jazzrobot/gshp-ebus/tools/README.md

# Tools

Helper scripts and utilities for maintaining the repository and processing captures live here.

See [scripts/README.md](scripts/README.md) for current scripts.
