jazzrobot/gshp-ebus/docs/decisions/README.md

# Architecture Decision Records

This directory records the decisions that shape the project in non-obvious ways.

Use an ADR when a choice changes safety, architecture, or future flexibility.

Current records:

- [0001-passive-read-only-mvp.md](0001-passive-read-only-mvp.md) - keep the MVP passive, isolated, and non-transmitting
