jazzrobot/gshp-ebus/home-assistant/entities/README.md

# Entities

This directory will hold the final list of Home Assistant entities once Phase 2 starts.

Likely early entities:

- target flow temperature
- actual flow temperature
- return temperature
- brine in temperature
- brine out temperature
- compressor state
