jazzrobot/gshp-ebus/tools/scripts/README.md

# Scripts

Current scripts:

- [generate-repo-structure.sh](generate-repo-structure.sh) - refresh `docs/repo-structure.md`
