jazzrobot/gshp-ebus/docs/repo-structure.md

# Repository Structure

This file is generated by `tools/scripts/generate-repo-structure.sh`.
Do not edit by hand.

```
.
├── docs
│   ├── architecture
│   │   ├── mvp-plan.md
│   │   └── overview.md
│   ├── debugging
│   │   └── common-failures.md
│   ├── decisions
│   │   ├── 0001-passive-read-only-mvp.md
│   │   └── README.md
│   ├── setup
│   │   └── live-ebus-install-checklist.md
│   ├── README.md
│   └── repo-structure.md
├── firmware
│   ├── esp32-s3-poe
│   │   ├── current
│   │   │   └── README.md
│   │   ├── dev
│   │   │   └── README.md
│   │   ├── README.md
│   │   └── VERSION_NOTES.md
│   └── README.md
├── hardware
│   ├── mechanical
│   │   └── README.md
│   ├── proto-v1
│   │   ├── README.md
│   │   ├── bom.csv
│   │   ├── build-notes.md
│   │   └── front-end.md
│   ├── proto-v2
│   │   ├── kicad
│   │   │   ├── README.md
│   │   │   ├── capture-notes.md
│   │   │   ├── ebus-rx-only.kicad_pro
│   │   │   └── ebus-rx-only.kicad_sch
│   │   ├── README.md
│   │   ├── bom.csv
│   │   ├── front-end.md
│   │   └── pcb-layout-notes.md
│   ├── proto-v3
│   │   └── README.md
│   └── README.md
├── home-assistant
│   ├── entities
│   │   └── README.md
│   ├── packages
│   │   └── README.md
│   └── README.md
├── logs
│   ├── bench-tests
│   │   └── README.md
│   ├── bus-captures
│   │   └── README.md
│   └── README.md
├── tools
│   ├── scripts
│   │   ├── README.md
│   │   └── generate-repo-structure.sh
│   └── README.md
├── CONVENTIONS.md
├── GETTING_STARTED.md
└── README.md

24 directories, 40 files
```
