jazzrobot/gshp-ebus/logs/bench-tests/README.md

# Bench Tests

Use this directory for bench validation notes before anything is attached to the live system.

Useful contents:

- interface validation notes
- firmware bring-up observations
- known-good and known-bad test conditions
