jazzrobot/gshp-ebus/logs/bus-captures/2026-03-23-tado-system-tests-2-time-anchors.csv

start_us | end_us | reason | wall_clock | weekday_bus | frame
169975763704 | 169975827550 | sync_boundary | 2026-03-23 22:05:12 | 1 | AA 10 FE B5 16 08 00 12 05 22 23 03 01 26 E2
170035751529 | 170035815335 | sync_boundary | 2026-03-23 22:06:12 | 1 | AA 10 FE B5 16 08 00 12 06 22 23 03 01 26 56
170095730204 | 170095793943 | sync_boundary | 2026-03-23 22:07:12 | 1 | AA 10 FE B5 16 08 00 12 07 22 23 03 01 26 B3
170155794118 | 170155857922 | sync_boundary | 2026-03-23 22:08:12 | 1 | AA 10 FE B5 16 08 00 12 08 22 23 03 01 26 7A
170215789040 | 170215852798 | sync_boundary | 2026-03-23 22:09:12 | 1 | AA 10 FE B5 16 08 00 12 09 22 23 03 01 26 9F
170276236131 | 170276300025 | sync_boundary | 2026-03-23 22:10:12 | 1 | AA 10 FE B5 16 08 00 12 10 22 23 03 01 26 80
170335741320 | 170335804975 | sync_boundary | 2026-03-23 22:11:12 | 1 | AA 10 FE B5 16 08 00 12 11 22 23 03 01 26 65
170395761729 | 170395825534 | sync_boundary | 2026-03-23 22:12:12 | 1 | AA 10 FE B5 16 08 00 12 12 22 23 03 01 26 D1
170455744669 | 170455808336 | sync_boundary | 2026-03-23 22:13:12 | 1 | AA 10 FE B5 16 08 00 12 13 22 23 03 01 26 34
170515695110 | 170515758581 | sync_boundary | 2026-03-23 22:14:12 | 1 | AA 10 FE B5 16 08 00 12 14 22 23 03 01 26 22
170578764178 | 170578827839 | sync_boundary | 2026-03-23 22:15:12 | 1 | AA 10 FE B5 16 08 00 12 15 22 23 03 01 26 C7
170635682116 | 170635745910 | sync_boundary | 2026-03-23 22:16:12 | 1 | AA 10 FE B5 16 08 00 12 16 22 23 03 01 26 73
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
172855380341 | 172855444254 | sync_boundary | 2026-03-23 22:53:12 | 1 | AA 10 FE B5 16 08 00 12 53 22 23 03 01 26 A0
172915358505 | 172915422285 | sync_boundary | 2026-03-23 22:54:12 | 1 | AA 10 FE B5 16 08 00 12 54 22 23 03 01 26 B6
172975877995 | 172975941744 | sync_boundary | 2026-03-23 22:55:12 | 1 | AA 10 FE B5 16 08 00 12 55 22 23 03 01 26 53
173035421880 | 173035485725 | sync_boundary | 2026-03-23 22:56:12 | 1 | AA 10 FE B5 16 08 00 12 56 22 23 03 01 26 E7
173095422132 | 173095485845 | sync_boundary | 2026-03-23 22:57:12 | 1 | AA 10 FE B5 16 08 00 12 57 22 23 03 01 26 02
173155400135 | 173155463847 | sync_boundary | 2026-03-23 22:58:12 | 1 | AA 10 FE B5 16 08 00 12 58 22 23 03 01 26 CB
173215398992 | 173215462774 | sync_boundary | 2026-03-23 22:59:12 | 1 | AA 10 FE B5 16 08 00 12 59 22 23 03 01 26 2E
173275377317 | 173275441104 | sync_boundary | 2026-03-23 23:00:12 | 1 | AA 10 FE B5 16 08 00 12 00 23 23 03 01 26 2A
