jazzrobot/gshp-ebus/(commit log)

2026-03-13 Initial commit — passive eBUS tap project
    Hardware design, documentation, and project structure for a passive
    telemetry capture system on a Vaillant flexoTHERM GSHP controlled
    by Tado HPO X over eBUS.
    Includes:
    - Proto v1 bus-powered breadboard front-end design and BOM
    - Proto v2 isolated DC-DC front-end design and KiCad source
    - Proto v3 placeholder for future transmit-capable interface
    - Architecture overview with hardware and software phase roadmap
    - MVP plan, live install checklist, and decision records
    - Repository conventions and structure rules
    Made-with: Cursor
    [bom.csv, ebus-rx-only.kicad_sch]
2026-03-16 Confirm ebus optocoupler design
    [bom.csv, ebus-rx-bus-powered.kicad_sch, ebus-rx-only.kicad_sch]
2026-03-16 Update BOM for proto V1 supply
    [bom.csv]
2026-03-22 Add overnight eBUS capture analysis and compressor event notes
    [2026-03-21-to-2026-03-22-overnight-families.csv, 2026-03-21-to-2026-03-22-overnight-logical-families-7b.csv, 2026-03-21-to-2026-03-22-overnight-time-anchors.csv]
2026-03-23 Add second overnight capture and baseline state
    [2026-03-22-to-2026-03-23-overnight-families.csv, 2026-03-22-to-2026-03-23-overnight-logical-families-7b.csv, 2026-03-22-to-2026-03-23-overnight-time-anchors.csv]
2026-03-23 Add 2026-03-23 Tado capture analyses and logs
    [2026-03-23-tado-system-tests-2-time-anchors.csv, 2026-03-23-tado-system-tests-time-anchors.csv]
